madeleinerhoward-max/Term-Project-0x04---Robert-Time-trials-and-Final-Deliverables/Romi test mount v2.STL

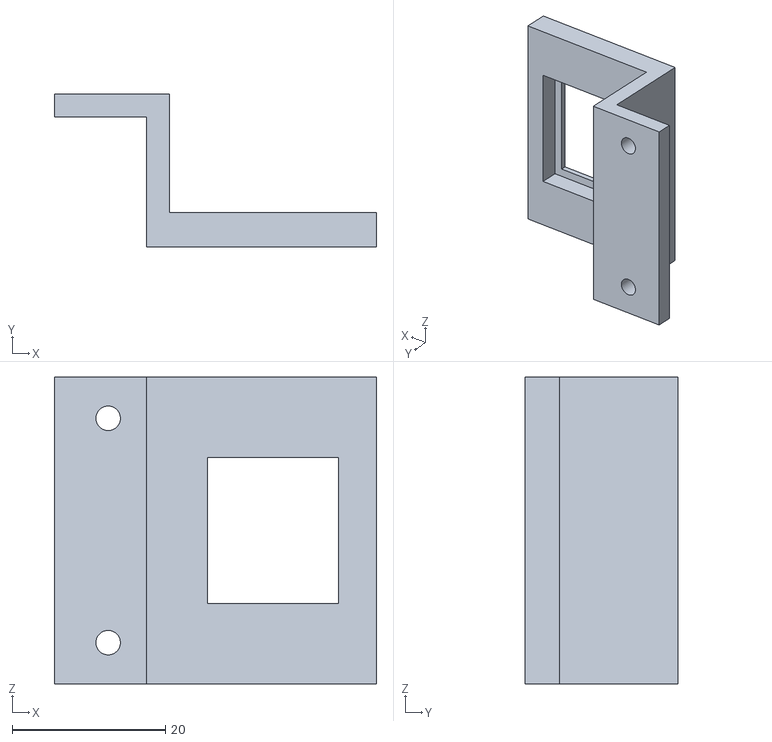
[picture p12: CAD file, 2026-03-21]
Romi test mount v2.STL
42.0 x 20.0 x 40.0
