madeleinerhoward-max/Term-Project-0x04---Robert-Time-trials-and-Final-Deliverables/(list of files, cad)

Other CAD files:
Romi test mount.SLDPRT
Romi Line Sensor Mount DrawingSLDDRW.SLDDRW
