madeleinerhoward-max/Term-Project-0x04---Robert-Time-trials-and-Final-Deliverables/build/html/_images/Rober_back.jpeg

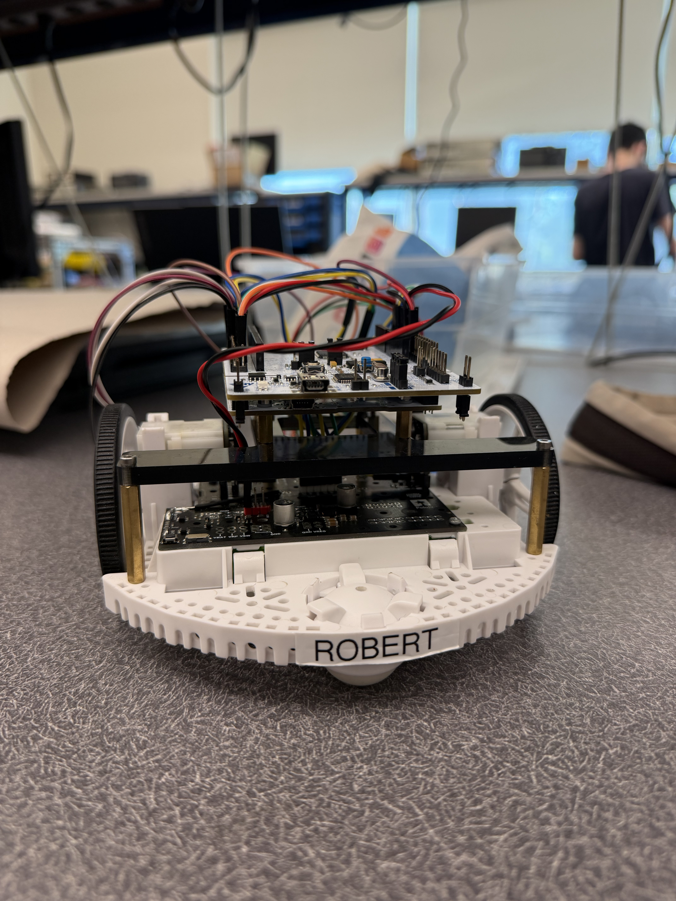
[picture p2: source/_static/Rober_back.jpeg]
build/html/_images/Rober_back.jpeg
